wbison3/Accionador-Manipulador-Electrico-Valvula-Bola-8-16v/Aspersores BoM - MercadoLibre México.md

Accionador Manipulador Electrico Válvula Bola 8-16v Plc Pic
https://articulo.mercadolibre.com.mx/MLM-830802031-accionador-manipulador-electrico-valvula-bola-8-16v-plc-pic-_JM

Arduino Uno
https://articulo.mercadolibre.com.mx/MLM-904241494-uno-r3-smd-tecneu-con-cable-usb-compatible-con-ide-arduino-_JM

Punte H Escudo para Arduino Uno
https://articulo.mercadolibre.com.mx/MLM-610700923-shield-l293d-puente-h-driver-motor-dual-arduino-uno-l293-_JM

Cargadores 12v 2a
https://articulo.mercadolibre.com.mx/MLM-797083315-eliminador-12v-2a-a-_JM

Enchufe inteligente
https://articulo.mercadolibre.com.mx/MLM-1364291101-enchufe-inteligente-wifi-sonoff-s31-control-voz-15a-contacto-_JM

Conector de barril macho
https://articulo.mercadolibre.com.mx/MLM-927719936-conectores-barril-macho-hembra-par-con-tornillos-_JM

Multicontactos
https://articulo.mercadolibre.com.mx/MLM-1810277766-multicontacto-divitech-6-entradas-y-cable-de-cobre-1800w-_JM

Es probable que ocupes algún extensor de Wi-Fi para que se conecte corretamente el enchufe inteligente.
https://www.mercadolibre.com.mx/router-tp-link-tl-wr840n-blanco/p/MLM15314118
