wbison3/Accionador-Manipulador-Electrico-Valvula-Bola-8-16v/Conexiones del Escudo Puente H.jpg

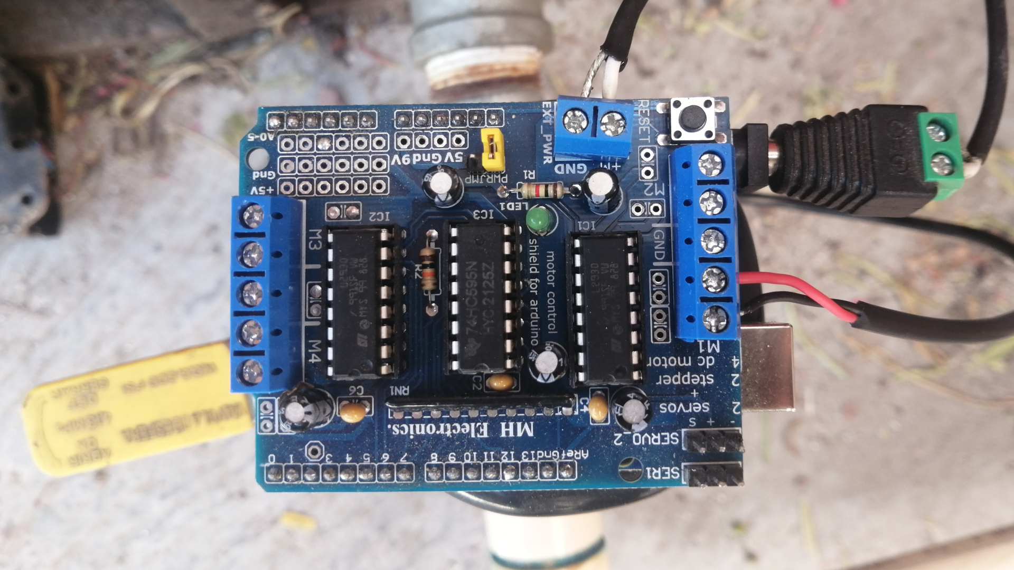
Conexiones del Escudo Puente H.jpg
