wbison3/Accionador-Manipulador-Electrico-Valvula-Bola-8-16v/Vista general.jpg

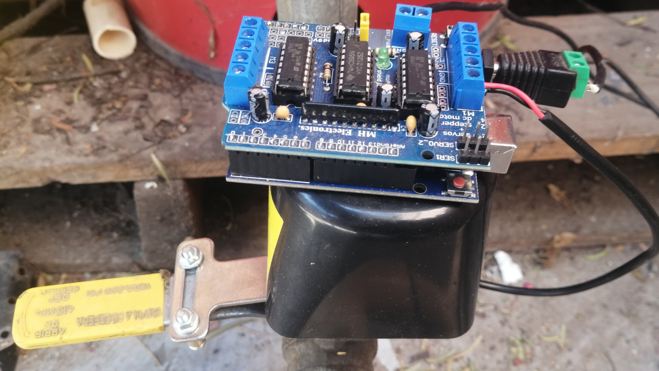
Vista general.jpg
